ChrisViviers/picoStreamDeck/ButtonMountFInal.stl

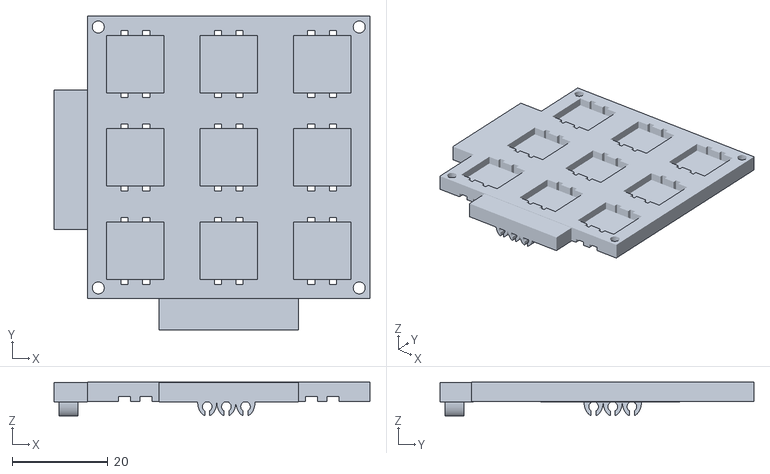
[picture p1: CAD file, 2026-10-29]
ButtonMountFInal.stl
66.0 x 65.5 x 7.00
